mcafzap/70cms-transverter/README.md

# 70cms-transverter for QO-100
