mcafzap/70cms-transverter/432trans21.pdf

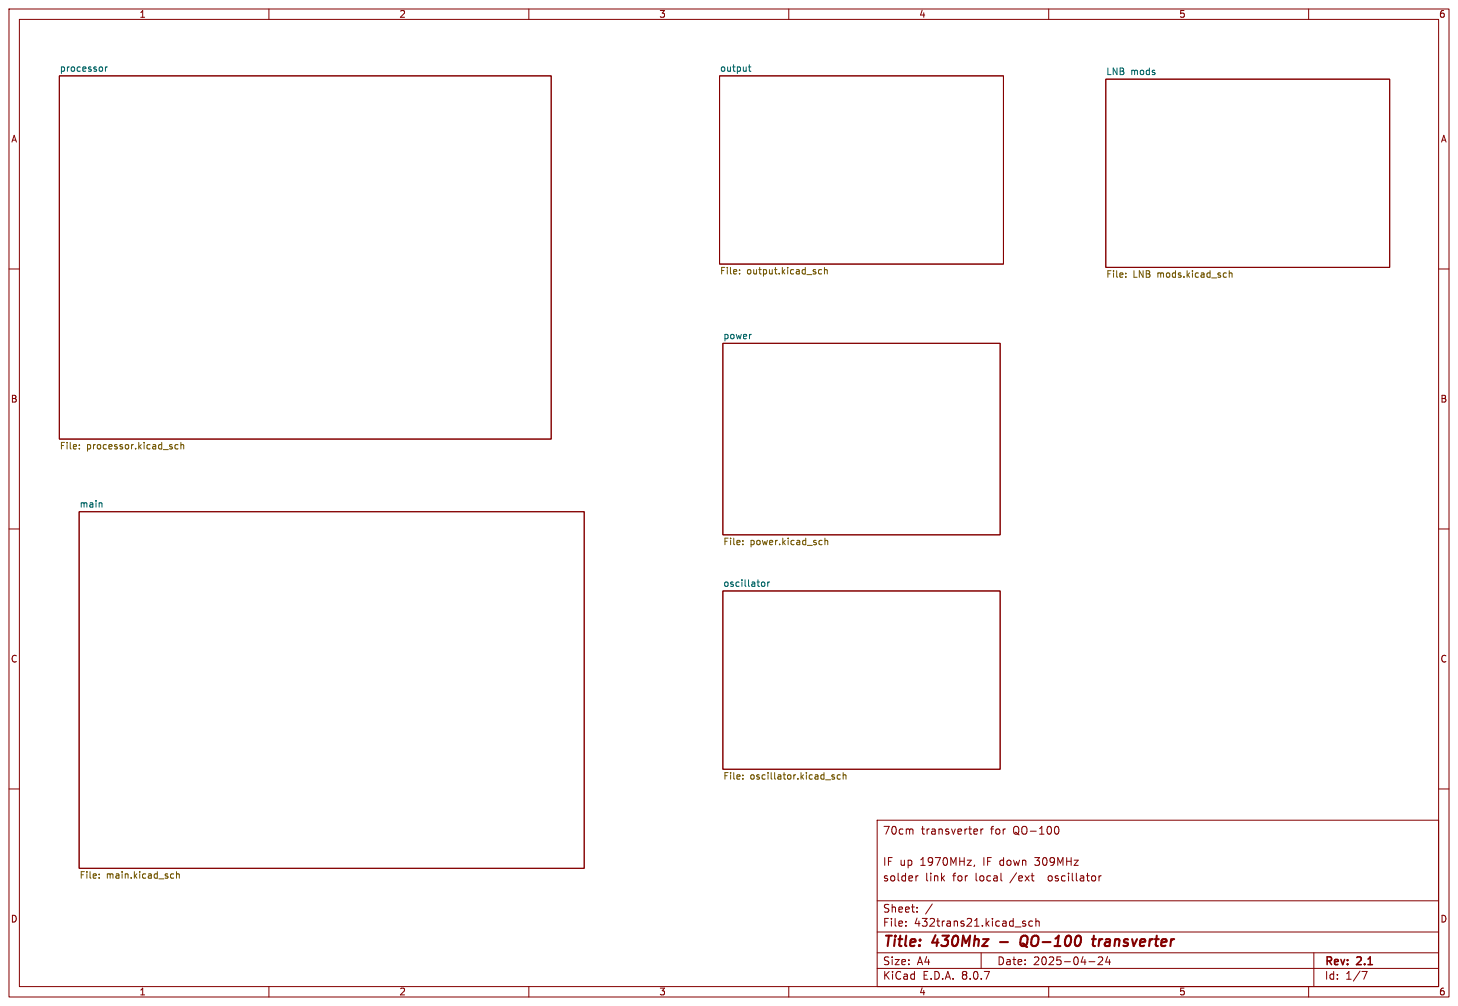
[picture p1: page 1]

LNB mods File: LNB mods.kicad_sch

power File: power.kicad_sch main File: main.kicad_sch

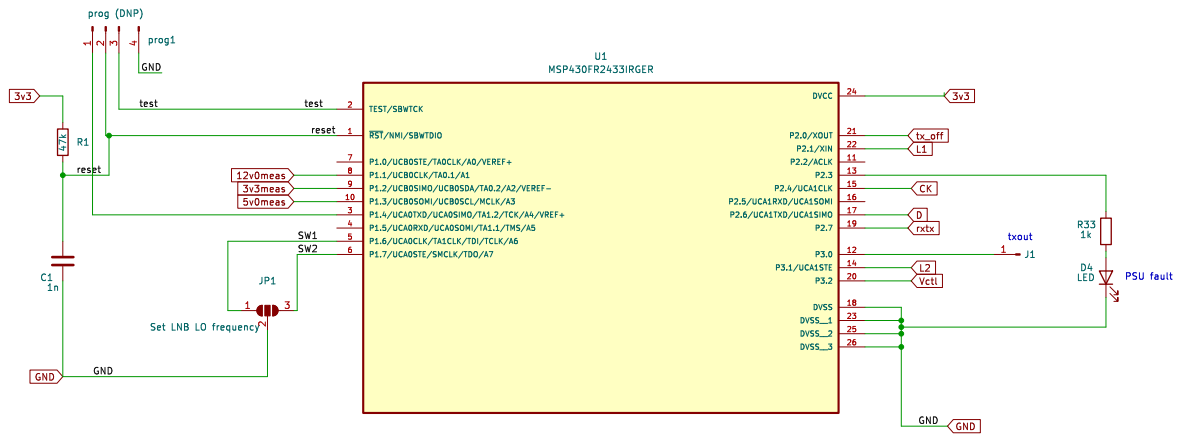
[picture p2: page 2]

JP1 Set LNB LO frequency C1

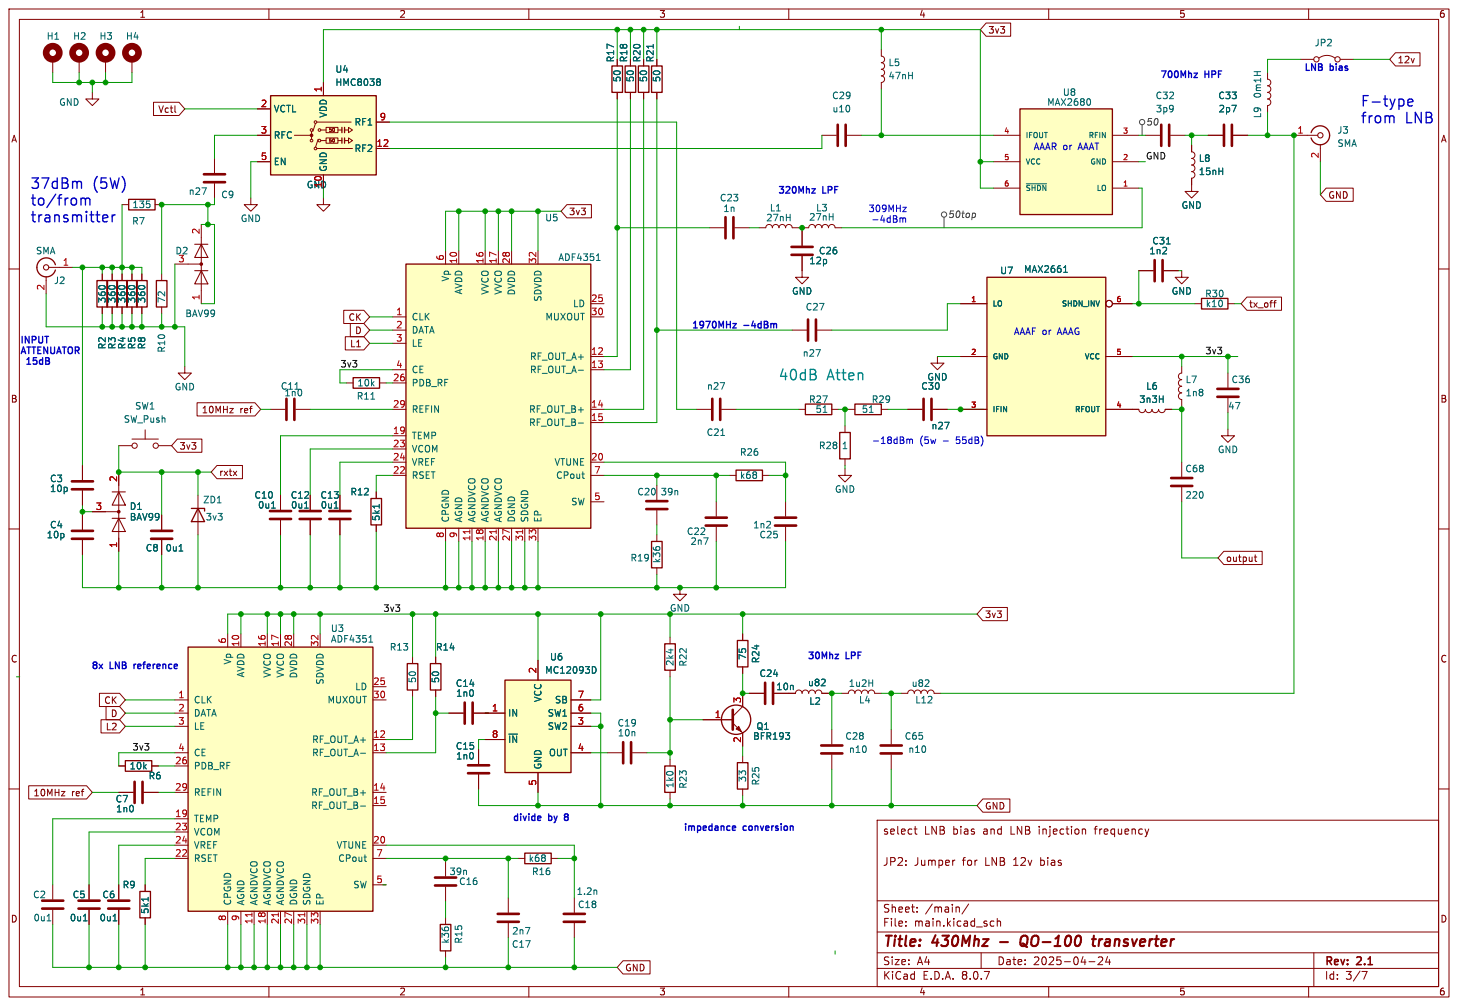
[picture p3: page 3]

1 GND 10 RF2 12 VCTL 2 RFC 3 EN 5 RF1 9 U4 HMC8038 GND R21 50 R18 50 R17 50 R20 50

700Mhz HPF AAAR or AAAT AAAF or AAAG

1 GND 10 RF2 12 VCTL 2 RFC 3 EN 5 RF1 9 R12 5k1 C13

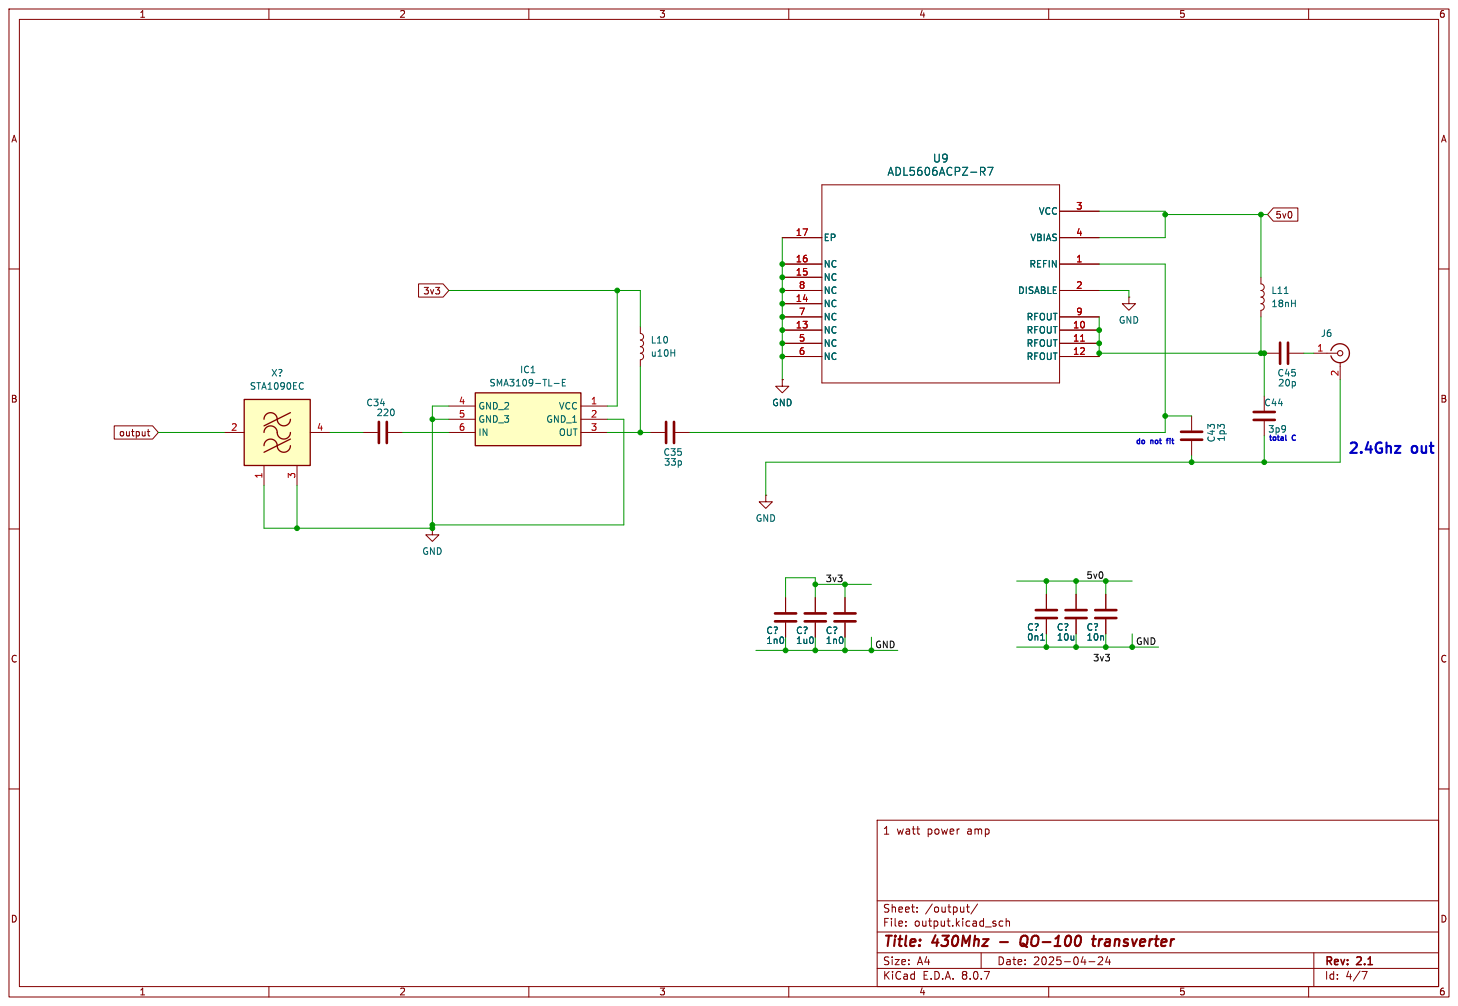
[picture p4: page 4]

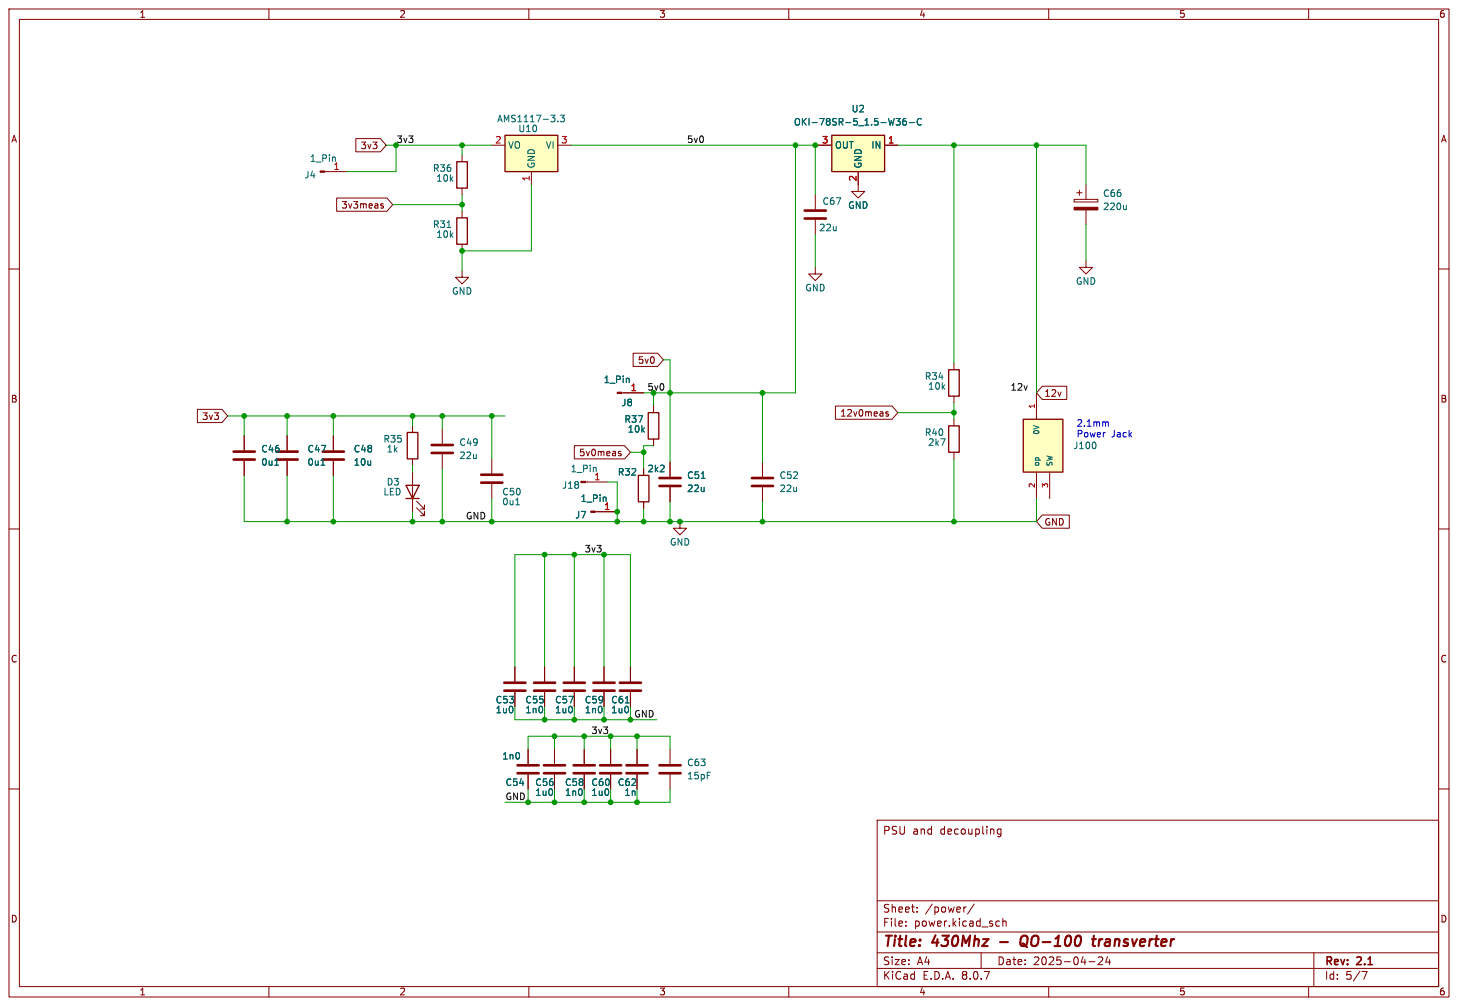
[picture p5: page 5]

2 OUT 3 U2 OKI-78SR-5_1.5-W36-C GND GND

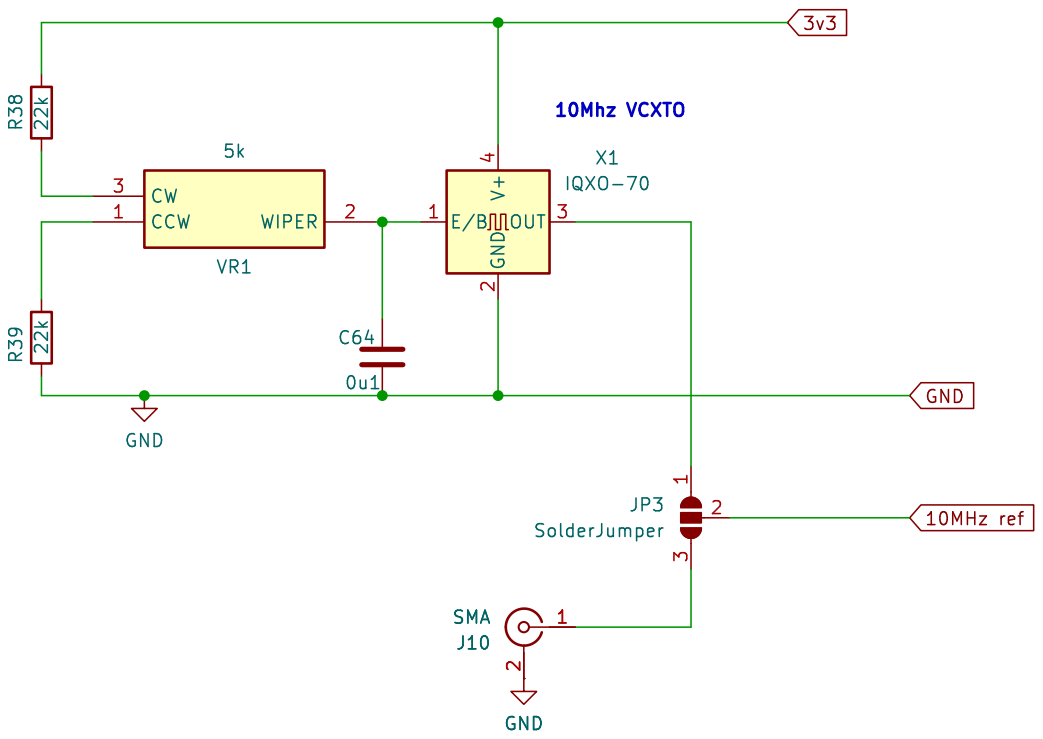
[picture p6: page 6]

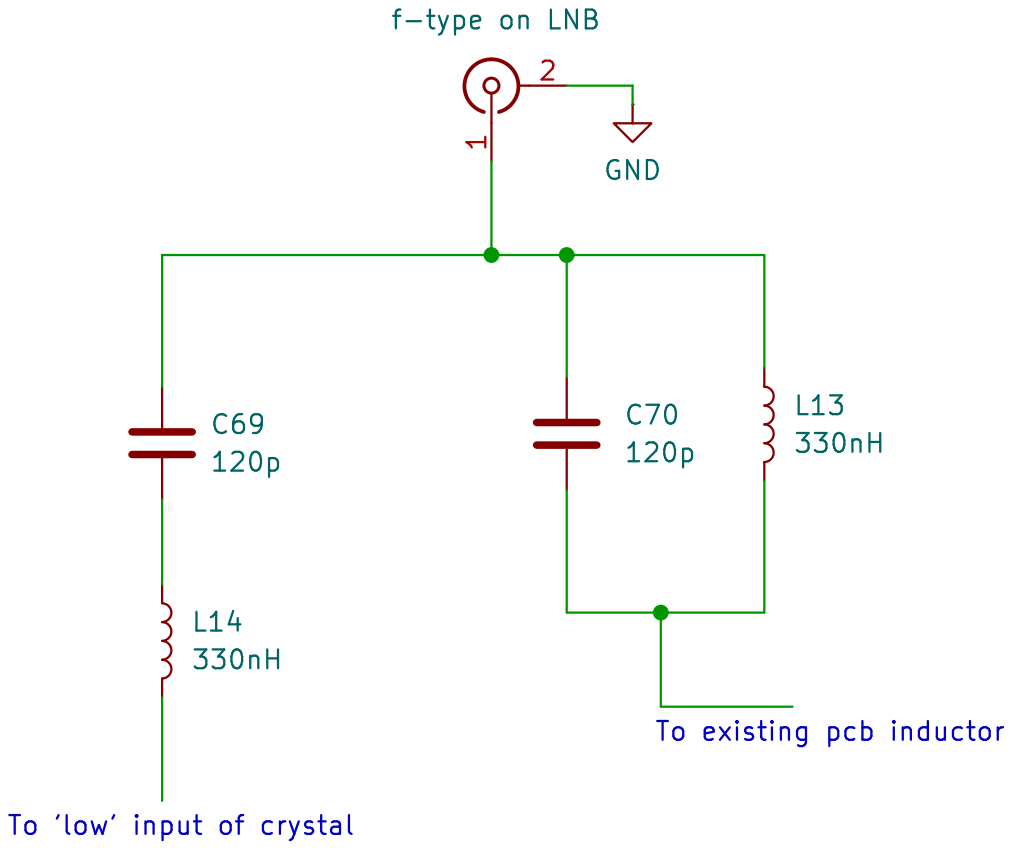
[picture p7: page 7]
