mcafzap/70cms-transverter/LNB mods.kicad_sch

## KiCad design LNB mods.kicad_sch (2025-07-14)

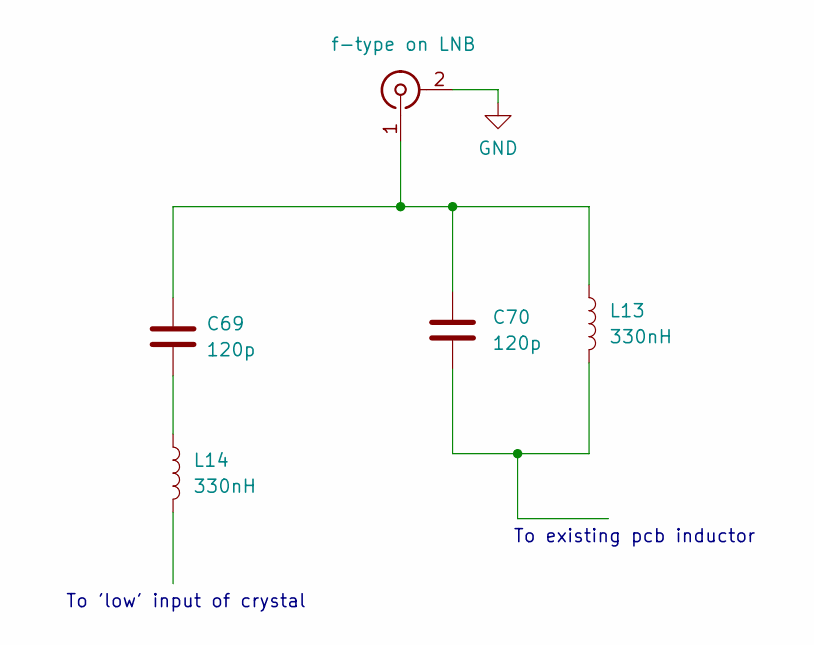
[picture p8: schematic LNB mods.kicad_sch]

Parts:
C69, C70: 120p
J5: f-type on LNB
L13, L14: 330nH

Connections:
GND: J5.2 (Ext)
unnamed: C69.1, C70.1, J5.1 (In), L13.1
unnamed: C69.2, L14.1
unnamed: C70.2, L13.2

Notes on the sheet:
To 'low' input of crystal
To existing pcb inductor
