mcafzap/70cms-transverter/main.kicad_sch

## KiCad design main.kicad_sch (2025-07-14)

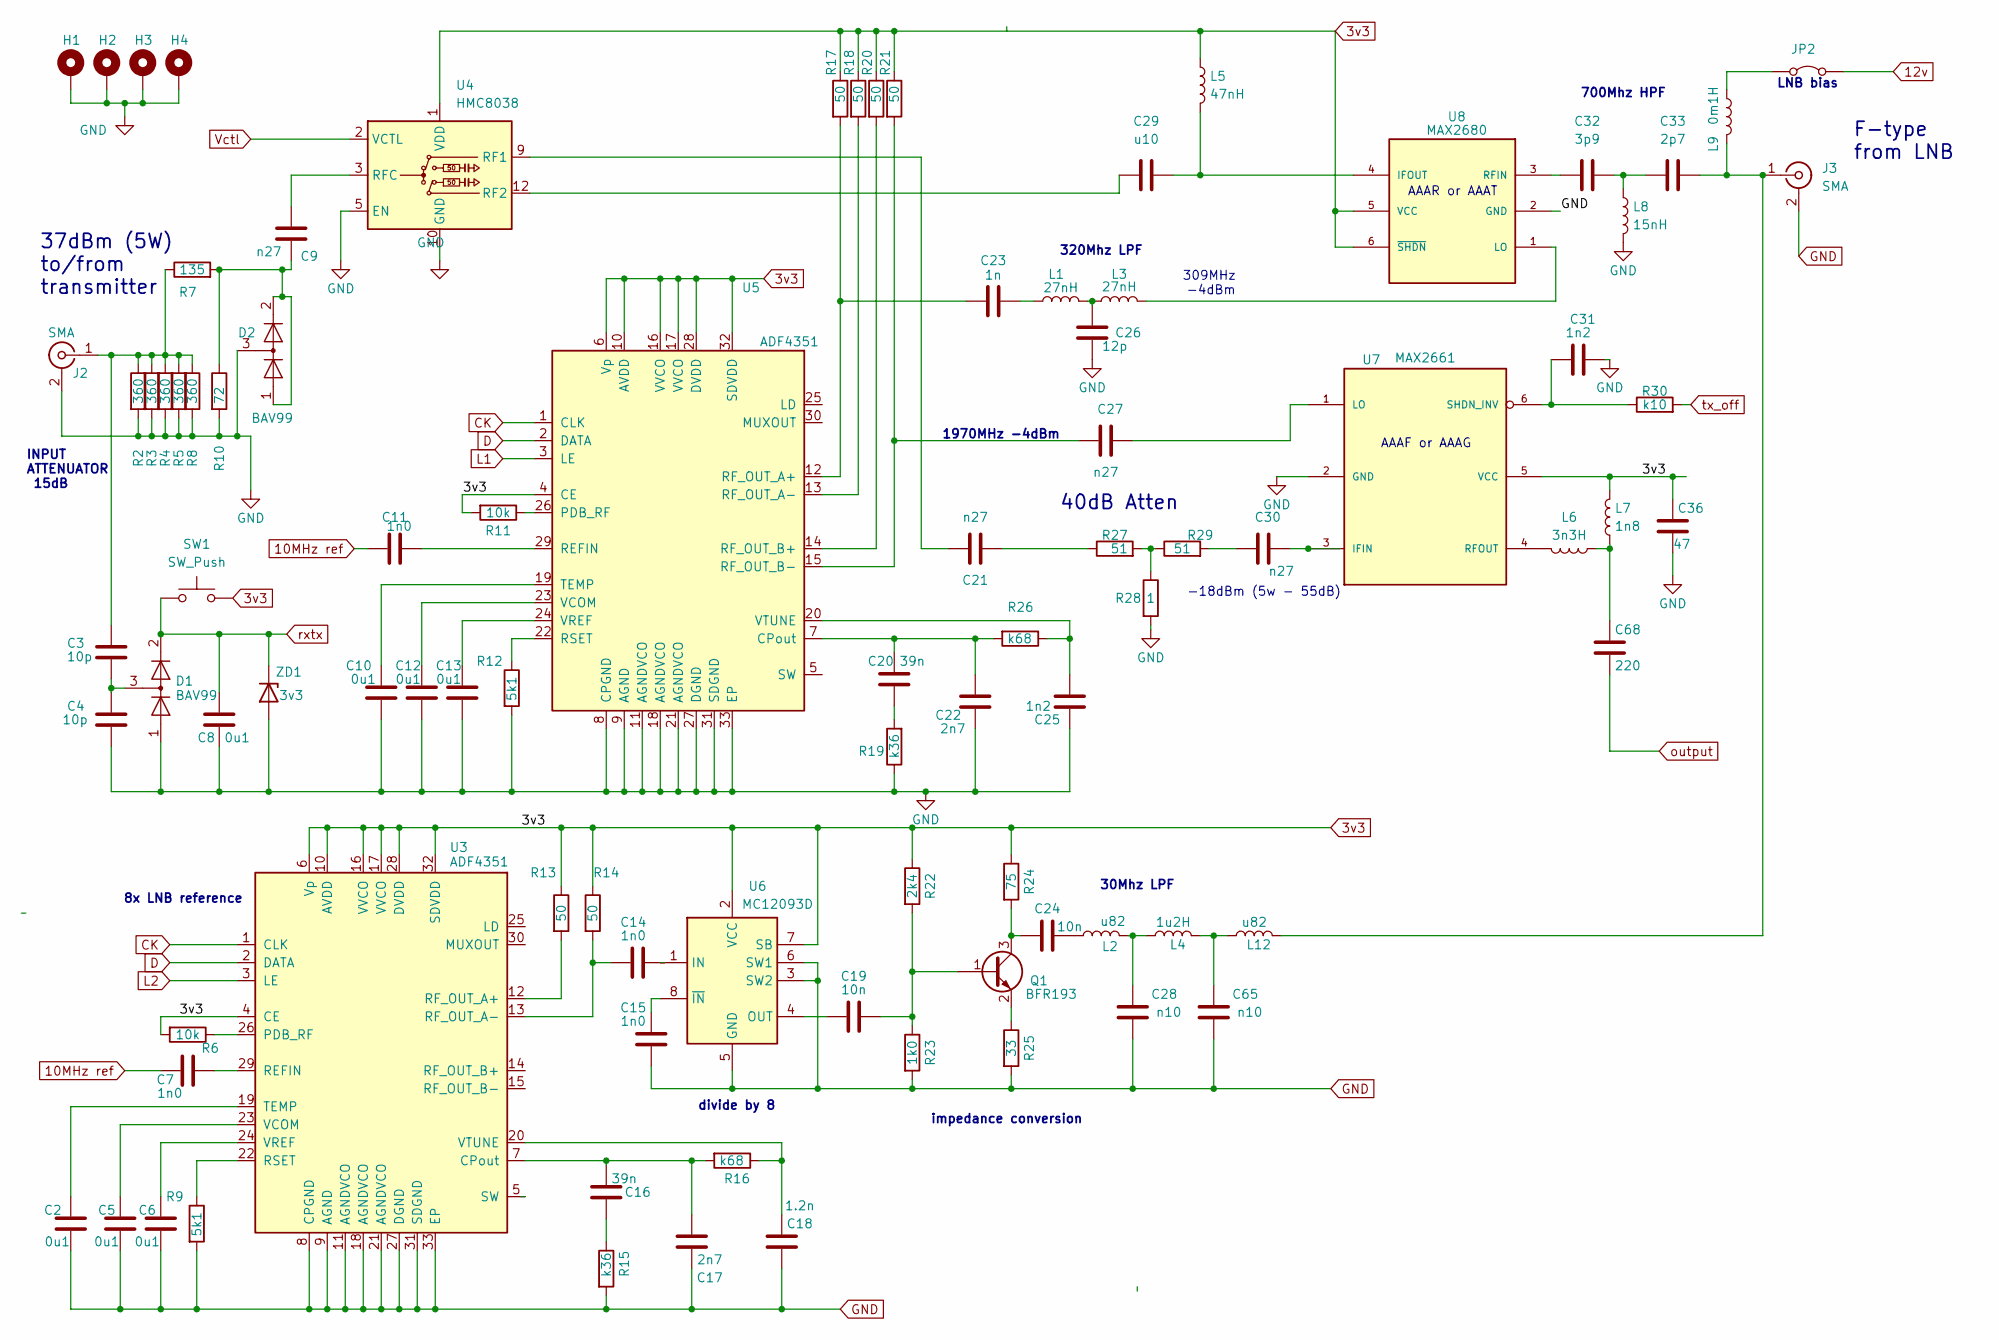
[picture p9: schematic main.kicad_sch]

Parts:
C2, C5, C6, C8, C10, C12, C13: 0u1; C_0603_1608Metric
C3, C4: 10p; C_0603_1608Metric
C7, C11, C14, C15: 1n0; C_0603_1608Metric
C9, C21, C27, C30: n27; C_0603_1608Metric
C16, C20: 39n; C_0603_1608Metric
C17, C22: 2n7; C_0603_1608Metric
C18: 1.2n; C_0603_1608Metric
C19, C24: 10n; C_0603_1608Metric
C23: 1n; C_0603_1608Metric
C25, C31: 1n2; C_0603_1608Metric
C26: 12p; C_0603_1608Metric
C28, C65: n10; C_0603_1608Metric
C29: u10; C_0603_1608Metric
C32: 3p9; C_0603_1608Metric
C33: 2p7; C_0603_1608Metric
C36: 47; C_0603_1608Metric
C68: 220; C_0603_1608Metric
D1, D2: BAV99; SOT-23
H1, H2, H3, H4: MountingHole_Pad; MountingHole_3.2mm_M3_ISO14580_Pad_TopBottom
J2, J3: SMA; SMA_Amphenol_132134_Vertical
JP2: Jumper_2_Bridged; SolderJumper-2_P1.3mm_Bridged2Bar_Pad1.0x1.5mm
L1, L3: 27nH; L_0603_1608Metric
L2, L12: u82; C_0603_1608Metric
L4: 1u2H; C_0603_1608Metric
L5: 47nH; L_0603_1608Metric
L6: 3n3H; L_0603_1608Metric
L7: 1n8; L_0603_1608Metric
L8: 15nH; L_0603_1608Metric
L9: 0m1H; L_0805_2012Metric
Q1: BFR193; SOT-23
R2, R3, R4, R5, R8: 360; R_2512_6332Metric
R6, R11: 10k; R_0603_1608Metric
R7: 135; R_2010_5025Metric
R9, R12: 5k1; R_0603_1608Metric
R10: 72; R_0603_1608Metric
R13, R14, R17, R18, R20, R21: 50; R_0603_1608Metric
R15, R19: k36; R_0603_1608Metric
R16, R26: k68; R_0603_1608Metric
R22: 2k4; R_0603_1608Metric
R23: 1k0; R_0603_1608Metric
R24: 75; R_0603_1608Metric
R25: 33; R_0603_1608Metric
R27, R29: 51; R_0603_1608Metric
R28: 1; R_0603_1608Metric
R30: k10; R_0603_1608Metric
SW1: SW_Push; SW_SPST_SKQG_WithStem
U3, U5: ADF4351; LFCSP-32-1EP_5x5mm_P0.5mm_EP3.25x3.25mm
U4: HMC8038; LFCSP-16-1EP_4x4mm_P0.65mm_EP2.4x2.4mm
U6: MC12093D; SOIC-8_3.9x4.9mm_P1.27mm
U7: MAX2661; SOT-23-6_Handsoldering
U8: MAX2680; SOT-23-6_Handsoldering; PARTNO MAX2680AUT+T-ND
ZD1: 3v3; D_0805_2012Metric_Pad1.15x1.40mm_HandSolder

Connections:
3v3: C36.1, L5.1, L7.2, R6.2, R11.2, R13.1, R14.1, R17.1, R18.1, R20.1, R21.1, R22.1, R24.1, SW1.2, U3.4 (CE), U3.6 (Vp), U3.10 (AVDD), U3.16 (VVCO), U3.17 (VVCO), U3.28 (DVDD), U3.32 (SDVDD), U4.1 (VDD), U5.4 (CE), U5.6 (Vp), U5.10 (AVDD), U5.16 (VVCO), U5.17 (VVCO), U5.28 (DVDD), U5.32 (SDVDD), U6.2 (VCC), U6.7 (SB), U7.5 (VCC), U8.5 (VCC), U8.6 (~SHDN)
10MHz ref: C7.2, C11.1
12v: JP2.2 (B)
CK: U3.1 (CLK), U5.1 (CLK)
D: U3.2 (DATA), U5.2 (DATA)
GND: C2.1, C4.2, C5.1, C6.1, C8.2, C10.1, C12.2, C13.2, C15.2, C17.2, C18.1, C22.2, C25.2, C26.1, C28.2, C31.2, C36.2, C65.2, D1.1 (K), D2.3 (K), H1.1, H2.1, H3.1, H4.1, J2.2 (Ext), J3.2 (Ext), L8.2, R2.2, R3.2, R4.2, R5.2, R8.2, R9.2, R10.2, R12.2, R15.2, R19.1, R23.2, R25.2, R28.2, U3.8 (CPGND), U3.9 (AGND), U3.11 (AGNDVCO), U3.18 (AGNDVCO), U3.21 (AGNDVCO), U3.27 (DGND), U3.31 (SDGND), U3.33 (EP), U4.4 (GND), U4.5 (EN), U4.6 (GND), U4.7 (GND), U4.8 (GND), U4.10 (GND), U4.11 (GND), U4.13 (GND), U4.14 (GND), U4.15 (GND), U4.16 (GND), U4.17 (GND), U5.8 (CPGND), U5.9 (AGND), U5.11 (AGNDVCO), U5.18 (AGNDVCO), U5.21 (AGNDVCO), U5.27 (DGND), U5.31 (SDGND), U5.33 (EP), U6.3 (SW2), U6.5 (GND), U6.6 (SW1), U7.2 (GND), U8.2 (GND), ZD1.2 (A)
L1: U5.3 (LE)
L2: U3.3 (LE)
unnamed: C2.2, U3.19 (TEMP)
unnamed: C3.1, J2.1 (In), R2.1, R3.1, R4.1, R5.1, R7.1, R8.1
unnamed: C3.2, C4.1, D1.3 (K)
unnamed: C5.2, U3.23 (VCOM)
unnamed: C6.2, U3.24 (VREF)
unnamed: C7.1, U3.29 (REFIN)
unnamed: C9.1, U4.3 (RFC)
unnamed: C9.2, D2.1 (K), D2.2 (A), R7.2, R10.1
unnamed: C10.2, U5.19 (TEMP)
unnamed: C11.2, U5.29 (REFIN)
unnamed: C12.1, U5.23 (VCOM)
unnamed: C13.1, U5.24 (VREF)
unnamed: C14.1, U6.1 (IN)
unnamed: C14.2, R14.2, U3.13 (RF_OUT_A-)
unnamed: C15.1, U6.8 (~IN)
unnamed: C16.1, R15.1
unnamed: C16.2, C17.1, R16.2, U3.7 (CPout)
unnamed: C18.2, R16.1, U3.20 (VTUNE)
unnamed: C19.1, Q1.1 (B), R22.2, R23.1
unnamed: C19.2, U6.4 (OUT)
unnamed: C20.1, C22.1, R26.2, U5.7 (CPout)
unnamed: C20.2, R19.2
unnamed: C21.1, R27.1
unnamed: C21.2, U4.9 (RF1)
unnamed: C23.1, L1.2
unnamed: C23.2, R17.2, U5.12 (RF_OUT_A+)
unnamed: C24.1, L2.1
unnamed: C24.2, Q1.3 (C), R24.2
unnamed: C25.1, R26.1, U5.20 (VTUNE)
unnamed: C26.2, L1.1, L3.2
unnamed: C27.1, U7.1 (LO)
unnamed: C27.2, R21.2, U5.15 (RF_OUT_B-)
unnamed: C28.1, L2.2, L4.1
unnamed: C29.1, L5.2, U8.4 (IFOUT)
unnamed: C29.2, U4.12 (RF2)
unnamed: C30.1, U7.3 (IFIN)
unnamed: C30.2, R29.2
unnamed: C31.1, R30.1, U7.6 (SHDN_INV)
unnamed: C32.1, C33.2, L8.1
unnamed: C32.2, U8.3 (RFIN)
unnamed: C33.1, J3.1 (In), L9.2, L12.2
unnamed: C65.1, L4.2, L12.1
unnamed: C68.1, L6.1, L7.1
unnamed: JP2.1 (A), L9.1
unnamed: L3.1, U8.1 (LO)
unnamed: L6.2, U7.4 (RFOUT)
unnamed: Q1.2 (E), R25.1
unnamed: R6.1, U3.26 (PDB_RF)
unnamed: R9.1, U3.22 (RSET)
unnamed: R11.1, U5.26 (PDB_RF)
unnamed: R12.1, U5.22 (RSET)
unnamed: R13.2, U3.12 (RF_OUT_A+)
unnamed: R18.2, U5.13 (RF_OUT_A-)
unnamed: R20.2, U5.14 (RF_OUT_B+)
unnamed: R27.2, R28.1, R29.1
Vctl: U4.2 (VCTL)
output: C68.2
rxtx: C8.1, D1.2 (A), SW1.1, ZD1.1 (K)
tx_off: R30.2

Notes on the sheet:
F-type from LNB
8x LNB reference
30Mhz LPF
-18dBm (5w - 55dB)
700Mhz HPF
impedance conversion
AAAR or AAAT
LNB bias
INPUT ATTENUATOR 15dB
37dBm (5W) to/from transmitter
1970MHz -4dBm
309MHz -4dBm
320Mhz LPF
AAAF or AAAG
40dB Atten
divide by 8
