mcafzap/70cms-transverter/oscillator.kicad_sch

## KiCad design oscillator.kicad_sch (2025-07-14)

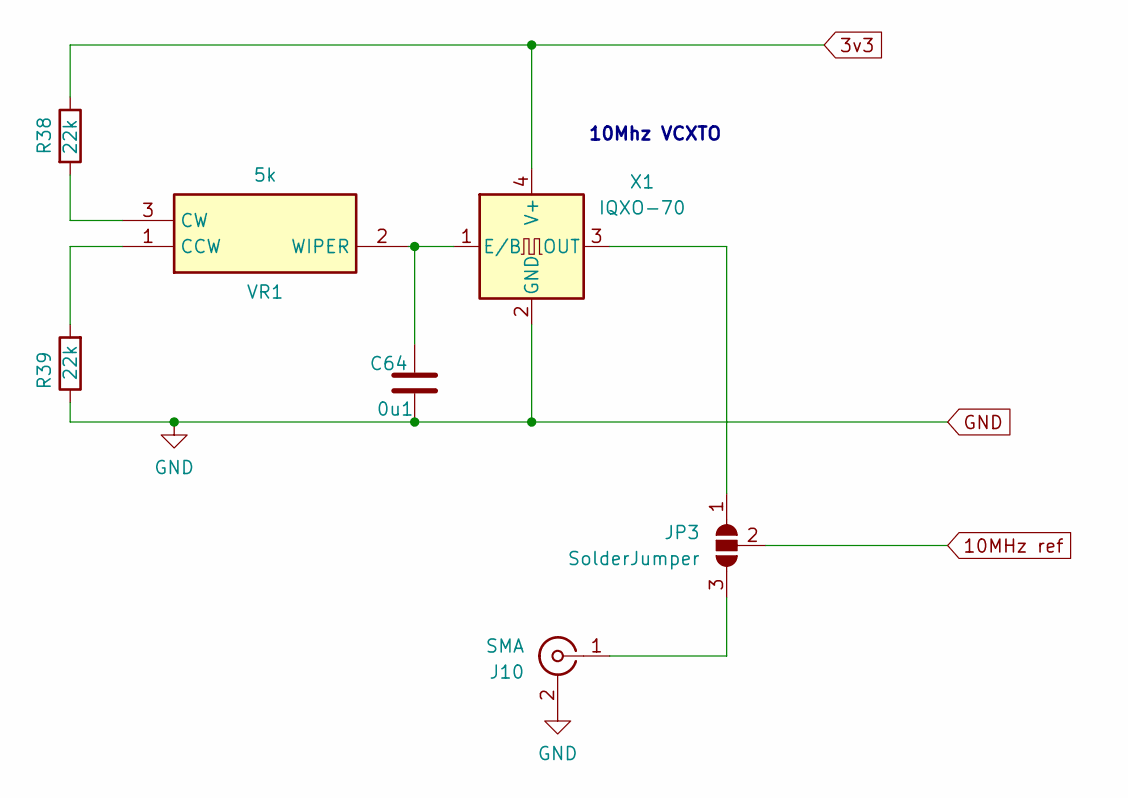
[picture p10: schematic oscillator.kicad_sch]

Parts:
C64: 0u1; C_0603_1608Metric
J10: SMA; SMA_Amphenol_132134_Vertical
JP3: SolderJumper; SolderJumper-3_P1.3mm_Open_RoundedPad1.0x1.5mm
R38, R39: 22k; R_0603_1608Metric
VR1: 5k; SM42TW503; Manufacturer_Part_Number SM-42TW503
X1: IQXO-70; Oscillator_SMD_IQD_IQXO70-4Pin_7.5x5.0mm

Connections:
3v3: R38.1, X1.4 (V+)
10MHz ref: JP3.2 (C)
GND: C64.1, J10.2 (Ext), R39.1, X1.2 (GND)
unnamed: C64.2, VR1.2 (WIPER), X1.1 (E/B)
unnamed: J10.1 (In), JP3.3 (B)
unnamed: JP3.1 (A), X1.3 (OUT)
unnamed: R38.2, VR1.3 (CW)
unnamed: R39.2, VR1.1 (CCW)

Notes on the sheet:
10Mhz VCXTO
