mcafzap/70cms-transverter/output.kicad_sch

## KiCad design output.kicad_sch (2025-07-14)

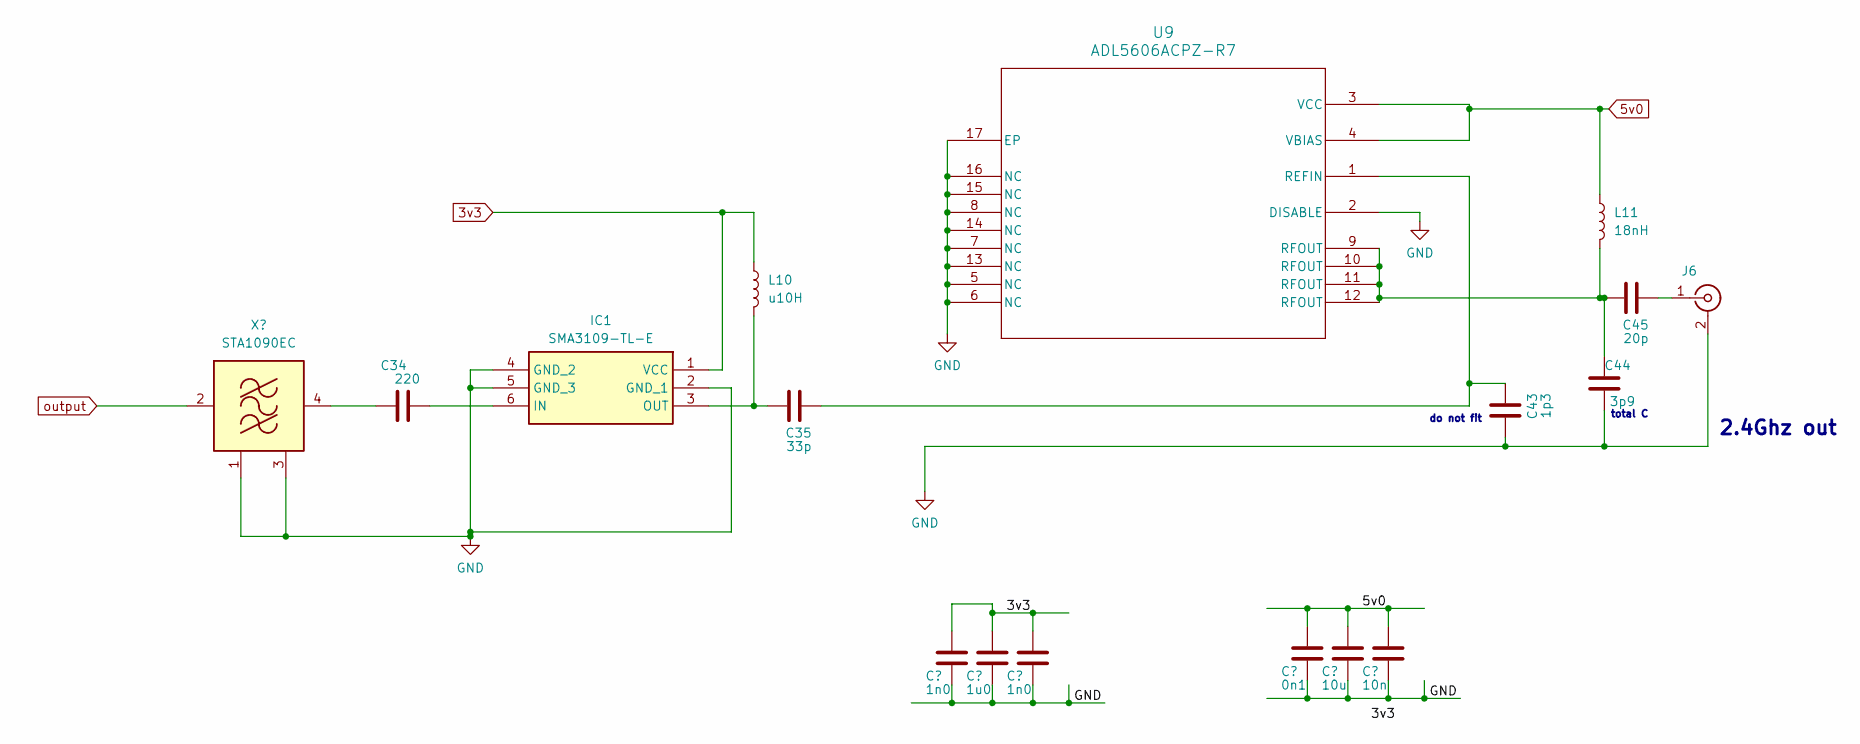
[picture p11: schematic output.kicad_sch]

Parts:
C34: 220; C_0603_1608Metric
C35: 33p; C_0603_1608Metric
C43: 1p3; C_0603_1608Metric
C44: 3p9; C_0603_1608Metric
C45: 20p; C_0603_1608Metric
IC1: SMA3109-TL-E; SOTFL65P210X90-6N; Manufacturer_Part_Number SMA3109-TL-E; Mouser Part Number 863-SMA3109-TL-E
J6: SMA; SMA_Amphenol_132134_Vertical
L10: u10H; L_0603_1608Metric
L11: 18nH; L_0805_2012Metric
U9: ADL5606ACPZ-R7; Analog_LFCSP-16-1EP_4x4mm_P0.65mm_EP2.1x2.1mm_ThermalVias

Connections:
3v3: IC1.1 (VCC), L10.1
5v0: L11.1, U9.3 (VCC), U9.4 (VBIAS)
unnamed: C34.2, IC1.6 (IN)
unnamed: C35.1, IC1.3 (OUT), L10.2
unnamed: C35.2, C43.2, U9.1 (REFIN)
unnamed: C43.1, C44.1, J6.2 (Ext)
unnamed: C44.2, C45.1, L11.2, U9.9 (RFOUT), U9.10 (RFOUT), U9.11 (RFOUT), U9.12 (RFOUT)
unnamed: C45.2, J6.1 (In)
unnamed: IC1.2 (GND_1), IC1.4 (GND_2), IC1.5 (GND_3)
unnamed: U9.5 (NC), U9.6 (NC), U9.7 (NC), U9.8 (NC), U9.13 (NC), U9.14 (NC), U9.15 (NC), U9.16 (NC), U9.17 (EP)

Notes on the sheet:
2.4Ghz out
total C
do not fit
