mcafzap/70cms-transverter/power.kicad_sch

## KiCad design power.kicad_sch (2025-07-14)

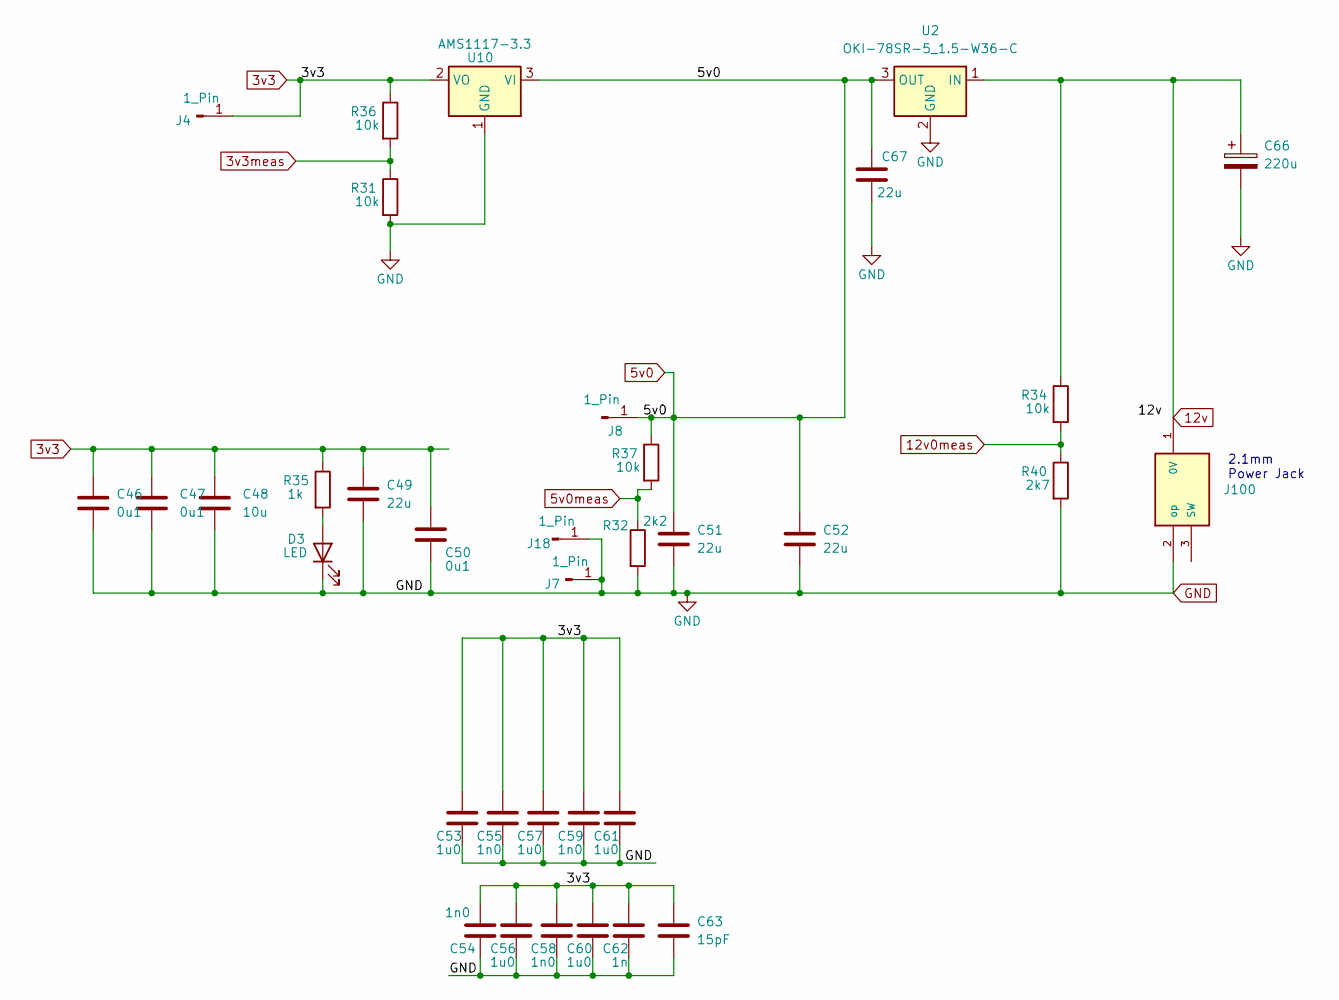
[picture p12: schematic power.kicad_sch]

Parts:
C46, C47, C50: 0u1; C_0603_1608Metric
C48: 10u; C_0603_1608Metric
C49, C51, C52, C67: 22u; C_0603_1608Metric
C53, C56, C57, C60, C61: 1u0; C_0603_1608Metric
C54, C55, C58, C59: 1n0; C_0603_1608Metric
C62: 1n; C_0603_1608Metric
C63: 15pF; C_0603_1608Metric
C66: 220u; CP_Radial_D8.0mm_P3.80mm
D3: LED; LED_0603_1608Metric
J4, J7, J8, J18: 1_Pin; Pin_D0.9mm_L10.0mm_W2.4mm_FlatFork
J100: 12v jack; BarrelJack_Horizontal; MOUSER_PART_NUMBER 163-179PH-EX
R31, R34, R36, R37: 10k; R_0603_1608Metric
R32: 2k2; R_0603_1608Metric
R35: 1k; R_0603_1608Metric
R40: 2k7; R_0603_1608Metric
U2: OKI-78SR-5_1.5-W36-C; Converter_DCDC_Murata_OKI-78SR_Vertical
U10: AMS1117-3.3; SOT-223-3_TabPin2

Connections:
3v3: C46.1, C47.1, C48.1, C49.1, C50.1, C53.1, C54.1, C55.1, C56.1, C57.1, C58.1, C59.1, C60.1, C61.1, C62.1, C63.2, J4.1, R35.1, R36.1, U10.2 (VO)
3v3meas: R31.1, R36.2
5v0: C51.1, C52.1, C67.1, J8.1, R37.1, U2.3 (OUT), U10.3 (VI)
5v0meas: R32.1, R37.2
12v: C66.1, J100.1 (0V), R34.1, U2.1 (IN)
12v0meas: R34.2, R40.1
GND: C46.2, C47.2, C48.2, C49.2, C50.2, C51.2, C52.2, C53.2, C54.2, C55.2, C56.2, C57.2, C58.2, C59.2, C60.2, C61.2, C62.2, C63.1, C66.2, C67.2, D3.1 (K), J7.1, J18.1, J100.2 (op), R31.2, R32.2, R40.2, U2.2 (GND), U10.1 (GND)
unnamed: D3.2 (A), R35.2

Notes on the sheet:
2.1mm Power Jack
