mcafzap/70cms-transverter/processor.kicad_sch

## KiCad design processor.kicad_sch (2025-07-14)

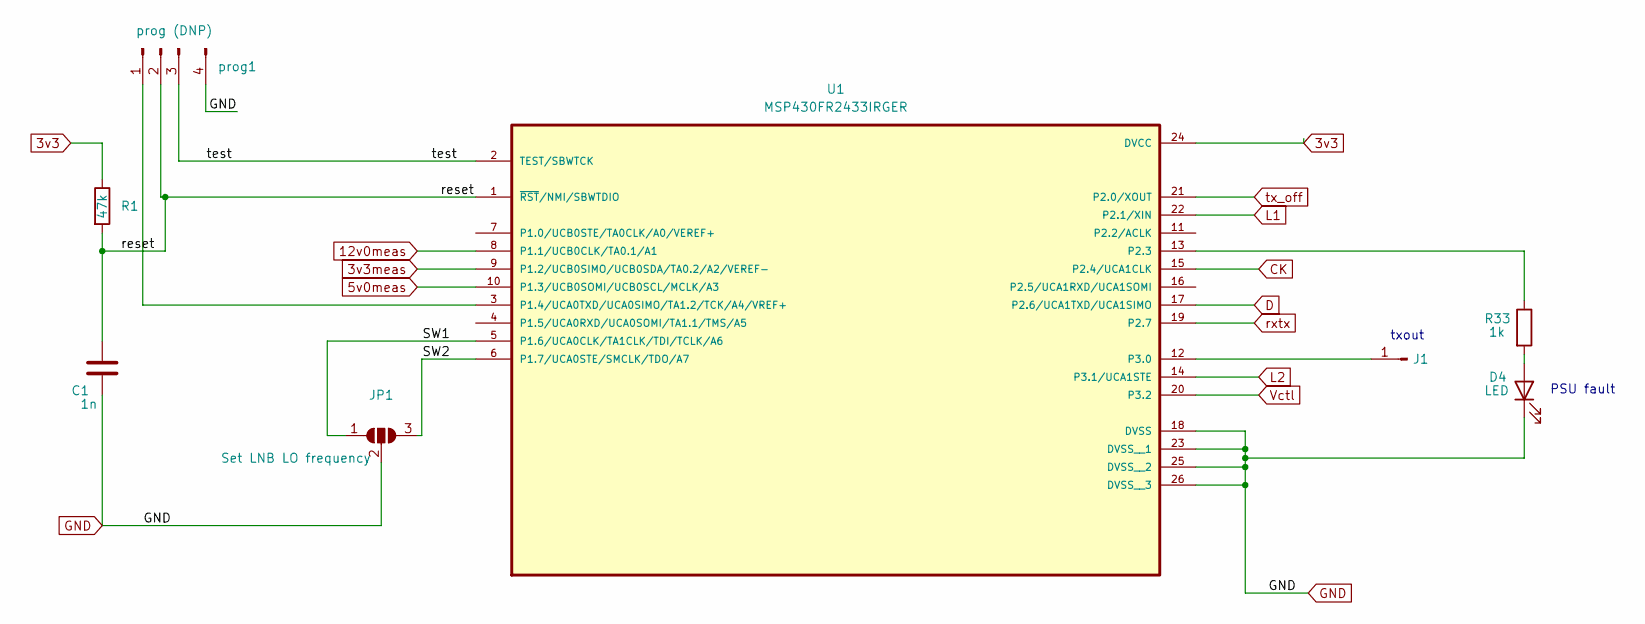
[picture p13: schematic processor.kicad_sch]

Parts:
C1: 1n; C_0603_1608Metric
D4: LED; LED_0603_1608Metric
J1: Txout1; Pin_D0.9mm_L10.0mm_W2.4mm_FlatFork; MANUFACTURER_PART_NUMBER 163-179PH-EX; MOUSER_PART_NUMBER 163-179PH-EX
JP1: Set LNB LO frequency; SolderJumper-3_P1.3mm_Open_RoundedPad1.0x1.5mm
R1: 47k; R_0603_1608Metric
R33: 1k; R_0603_1608Metric
U1: MSP430FR2433IRGER; QFN50P400X400X100-25N; PARTREV 8/2017
prog1: prog (DNP); PinHeader_1x04_P2.54mm_Vertical

Connections:
3v3: R1.1, U1.24 (DVCC)
3v3meas: U1.9 (P1.2/UCB0SIMO/UCB0SDA/TA0.2/A2/VEREF-)
5v0meas: U1.10 (P1.3/UCB0SOMI/UCB0SCL/MCLK/A3)
12v0meas: U1.8 (P1.1/UCB0CLK/TA0.1/A1)
CK: U1.15 (P2.4/UCA1CLK)
D: U1.17 (P2.6/UCA1TXD/UCA1SIMO)
GND: C1.2, D4.1 (K), JP1.2 (C), U1.18 (DVSS), U1.23 (DVSS__1), U1.25 (DVSS__2), U1.26 (DVSS__3), prog1.4 (Pin_1)
L1: U1.22 (P2.1/XIN)
L2: U1.14 (P3.1/UCA1STE)
unnamed: D4.2 (A), R33.2
unnamed: J1.1, U1.12 (P3.0)
unnamed: R33.1, U1.13 (P2.3)
unnamed: U1.3 (P1.4/UCA0TXD/UCA0SIMO/TA1.2/TCK/A4/VREF+), prog1.1
SW1: JP1.1 (A), U1.5 (P1.6/UCA0CLK/TA1CLK/TDI/TCLK/A6)
SW2: JP1.3 (B), U1.6 (P1.7/UCA0STE/SMCLK/TDO/A7)
Vctl: U1.20 (P3.2)
reset: C1.1, R1.2, U1.1 (~RST/NMI/SBWTDIO), prog1.2
rxtx: U1.19 (P2.7)
test: U1.2 (TEST/SBWTCK), prog1.3
tx_off: U1.21 (P2.0/XOUT)

Notes on the sheet:
PSU fault
txout
